marcel-gruszecki/Autonomous-AGV/(list of files, cad)

Other CAD files:
Warehouse_model/Warehouse.dwg
