marcel-gruszecki/Autonomous-AGV/Scheme/Scheme.kicad_pcb

## KiCad design Scheme/Scheme.kicad_pcb (2026-09-07)

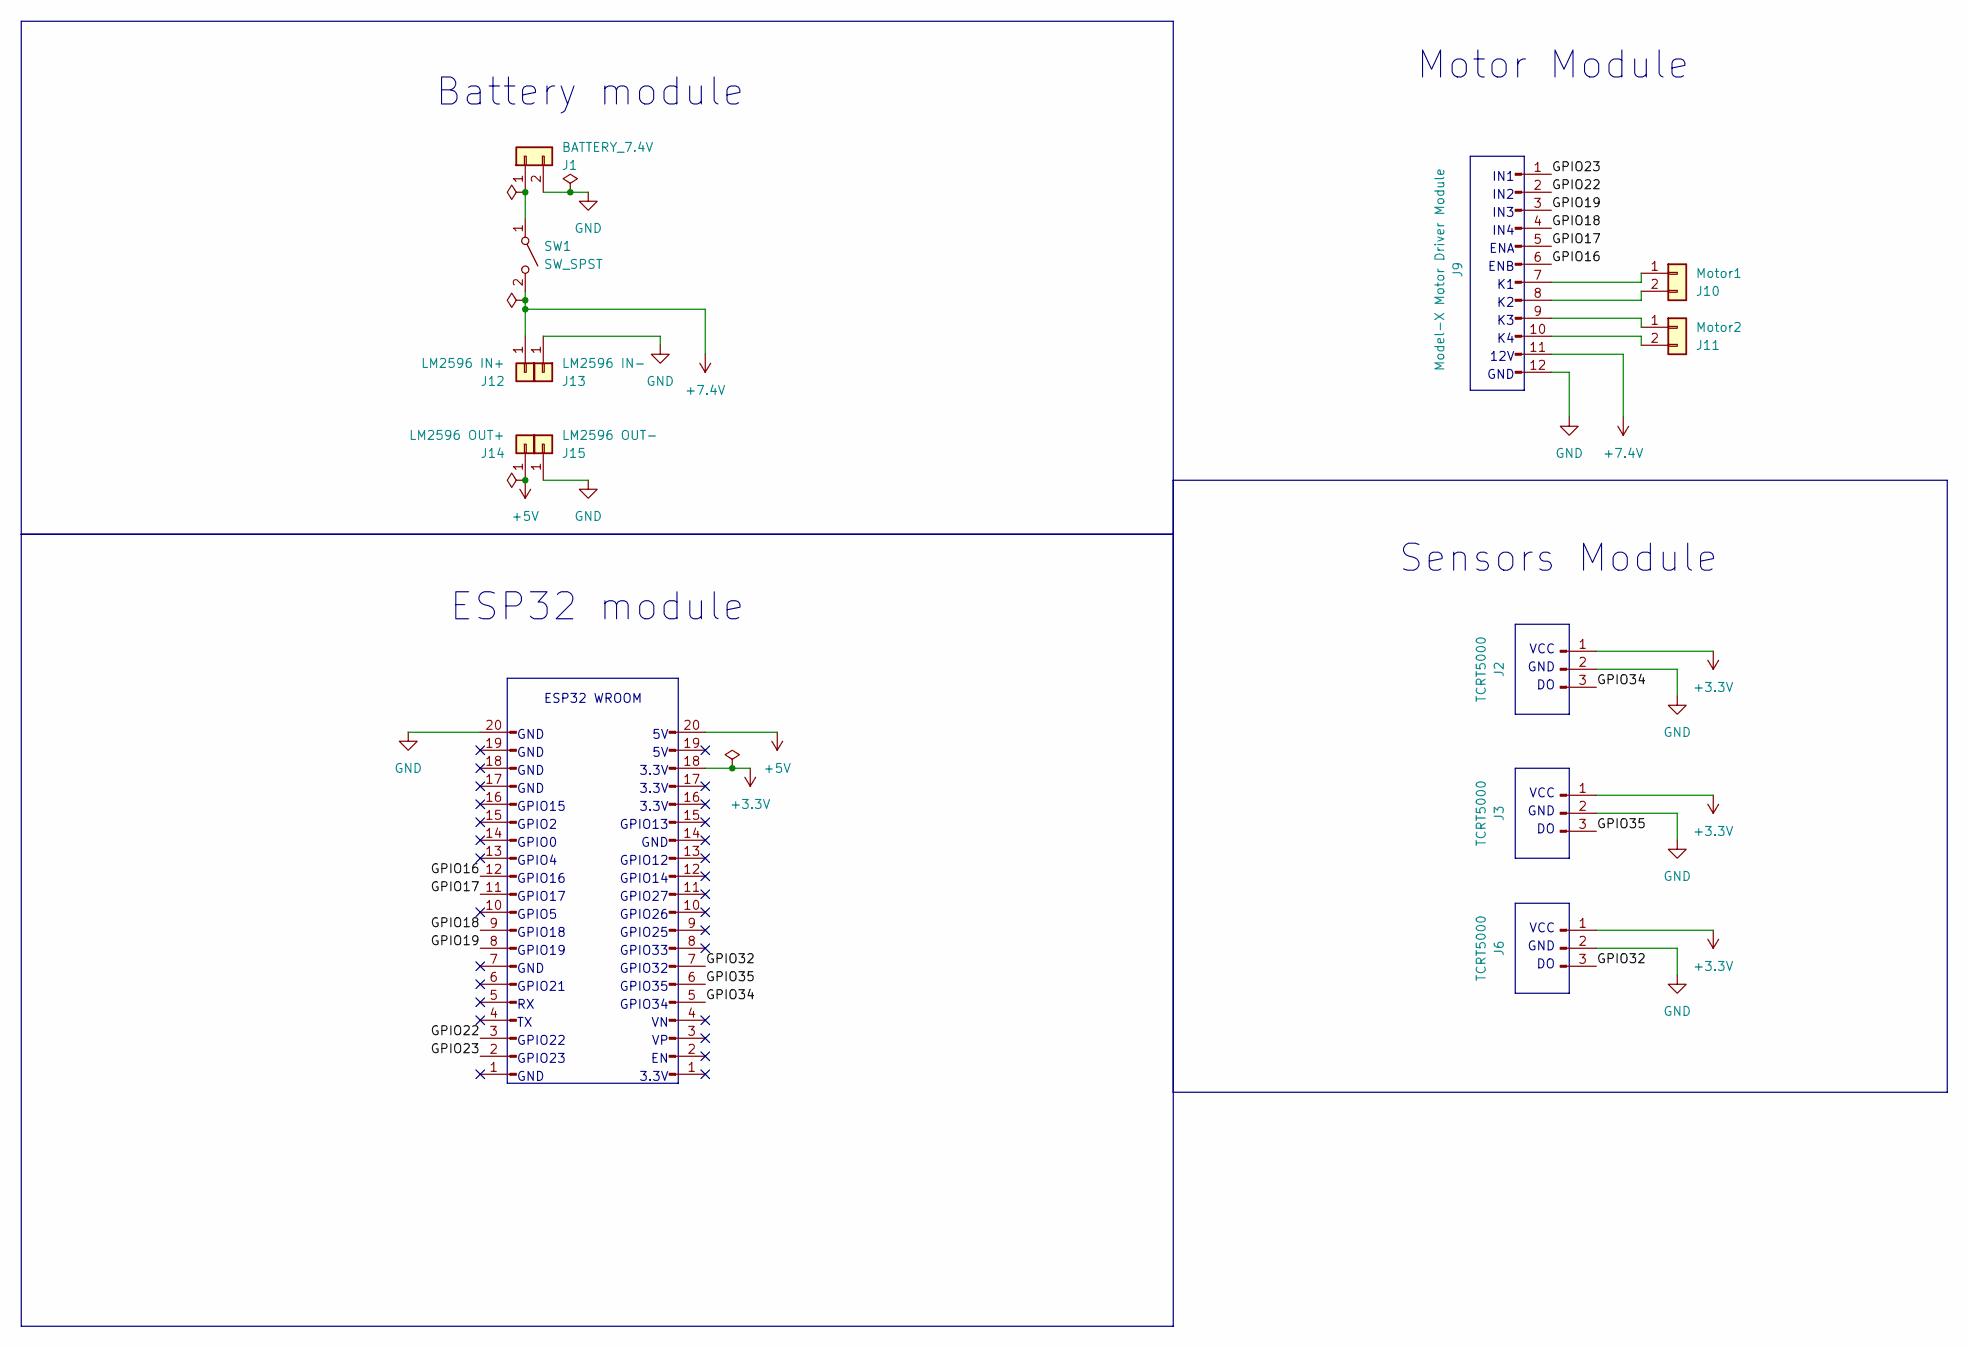
[picture p4: schematic Scheme.kicad_sch, OSOYOO 2WD Robot Car - ESP32 Upgrade]

Parts:
J1: BATTERY_7.4V; PinHeader_1x02_P2.54mm_Vertical
J2, J3, J6: TCRT5000; PinSocket_1x03_P2.54mm_Vertical
J4, J5: Conn_01x20_Pin; PinSocket_1x20_P2.54mm_Vertical
J9: Model-X Motor Driver Module; PinSocket_1x12_P2.54mm_Vertical
J10: Motor1; PinHeader_1x02_P2.54mm_Vertical
J11: Motor2; PinHeader_1x02_P2.54mm_Vertical
J12: LM2596 IN+; TestPoint_Pad_3.0x3.0mm
J13: LM2596 IN-; TestPoint_Pad_3.0x3.0mm
J14: LM2596 OUT+; TestPoint_Pad_3.0x3.0mm
J15: LM2596 OUT-; TestPoint_Pad_3.0x3.0mm
SW1: SW_SPST; PinSocket_1x02_P2.54mm_Vertical

Connections:
+3.3V: J2.1, J3.1, J4.18, J6.1
+5V: J4.20, J14.1 (Pin_1_1)
+7.4V: J9.11, J12.1 (Pin_1_1), SW1.2 (B)
/<NO NET>: J4.3
/GPIO16: J5.12, J9.6
/GPIO17: J5.11, J9.5
/GPIO18: J5.9, J9.4
/GPIO19: J5.8, J9.3
/GPIO22: J5.3, J9.2
/GPIO23: J5.2, J9.1
/GPIO32: J4.7, J6.3
/GPIO34: J2.3, J4.5
/GPIO35: J3.3, J4.6
GND: J1.2, J2.2, J3.2, J5.20, J6.2, J9.12, J13.1 (Pin_1_1), J15.1 (Pin_1_1)
unnamed: J1.1, SW1.1 (A)
unnamed: J9.7, J10.1
unnamed: J9.8, J10.2
unnamed: J9.9, J11.1
unnamed: J9.10, J11.2

Notes on the sheet:
12V
GPIO4
GPIO32
ENB
GND
GPIO33
GPIO21
GPIO34
3.3V
GPIO2
GPIO23
Battery module
GPIO18
GPIO22
GPIO12
ESP32 module
IN2
Motor Module
IN1
GPIO14
GPIO17
GPIO27
Sensors Module
IN4
VCC
GPIO19
IN3
GPIO15
GPIO13
GPIO25
GPIO0
GPIO26
ESP32 WROOM
GPIO16
ENA
GPIO35
GPIO5

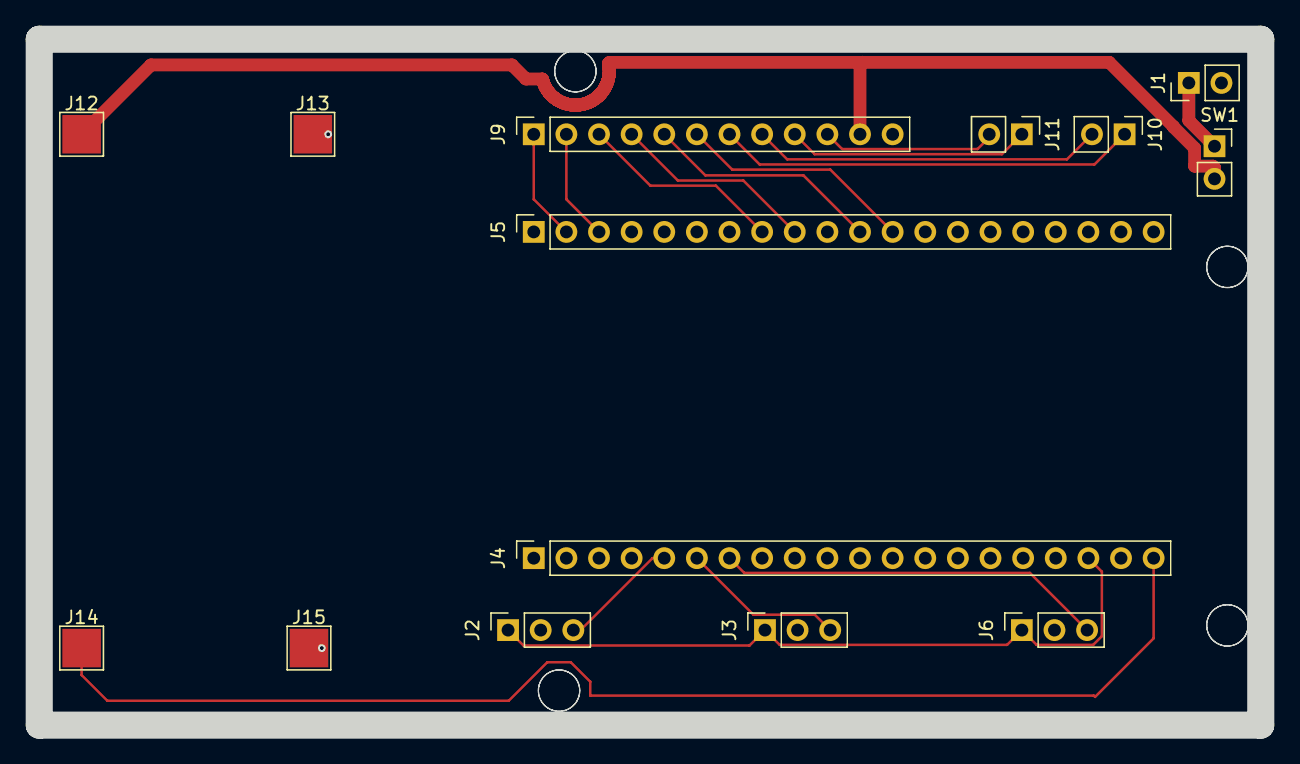
[picture p5: board Scheme.kicad_pcb from above]

Board: 2 copper layers, 95.1 x 53.4 mm, 14 parts (0 on the bottom side), 18 nets.
