marcel-gruszecki/Autonomous-AGV/OSOYOO/include/config.example.hpp

// Copy this file to config.hpp and fill in your values.
#pragma once

const char* const WIFI_SSID = "your-wifi";
const char* const WIFI_PASS = "your-password";
const char* const SERVER_URL = "http://192.168.1.10:8080";   // PC running Serwer/serwer.py

// Different for every robot, must match the ids in Serwer/serwer.py
#define ROBOT_ID "1"
