marcel-gruszecki/Autonomous-AGV/(commit log)

2026-10-18 warehouse model
    [Warehouse.dwg]
2026-10-26 New warehouse layout
    [Warehouse.dwg]
